EthicalAesthetic/kavacha/coremark/coremark_sim.png

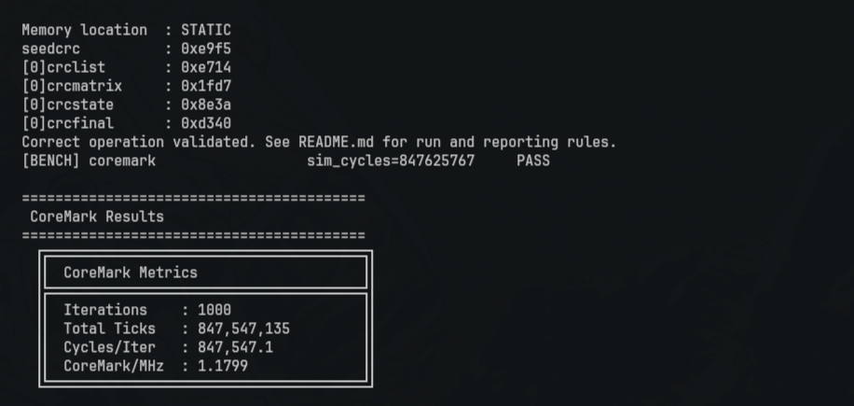
coremark/coremark_sim.png
