EthicalAesthetic/kavacha/dhrystone/dhry_sim.png

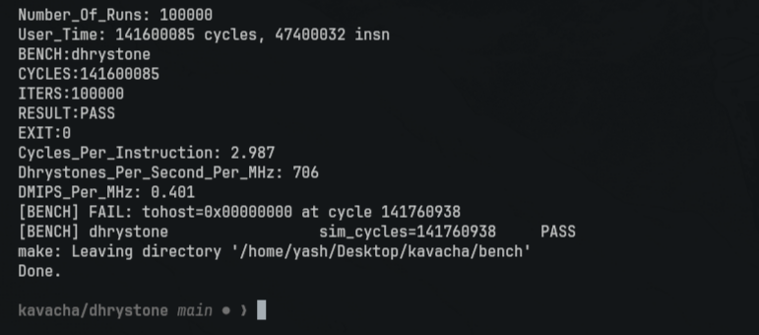
dhrystone/dhry_sim.png
