EthicalAesthetic/kavacha/tb/tb_kavacha.sv

// ============================================================================
// tb_kavacha.sv — Self-checking testbench for kavacha_soc.
//
//   vvp sim/tb_kavacha +IMEM=programs/build/smoke.hex
//   vvp sim/tb_kavacha +IMEM=... +TRACE=1   (emit retire trace for co-sim)
//   vvp sim/tb_kavacha +IMEM=... +DRAM=<hex>  (also preload DRAM @0x8000_0000)
//   vvp sim/tb_kavacha +IMEM=... +MAXCYC=<n>  (cycle limit, default 200000)
//   vvp sim/tb_kavacha +IMEM=... +IMEM_WRITABLE
//       testbench memory model only: data stores into the IMEM window also
//       update IMEM (the SoC's IMEM is fetch + read-only data). run_isa.sh uses
//       it because riscv-tests expect one read/write memory (rv32uc/rvc stores
//       into data placed in its own code section).
//
// Exit protocol: a store to tohost (0x2000_0000) ends the run.
//   tohost == 1  -> PASS
//   tohost != 1  -> FAIL
// ============================================================================
`timescale 1ns/1ps

module tb_kavacha;
  logic clk = 1'b0;
  always #5 clk = ~clk;

  logic rst;

  logic [31:0] tohost;
  logic        tohost_we;
  logic        retire_valid;
  logic [31:0] retire_pc, retire_instr, retire_rd_val;
  logic        retire_rd_we;
  logic [4:0]  retire_rd;

  kavacha_soc dut (
    .clk(clk), .rst(rst),
    .tck(1'b0), .tms(1'b0), .tdi(1'b0), .tdo(),
    .tohost(tohost), .tohost_we(tohost_we),
    .retire_valid(retire_valid), .retire_pc(retire_pc),
    .retire_instr(retire_instr), .retire_rd_we(retire_rd_we),
    .retire_rd(retire_rd), .retire_rd_val(retire_rd_val)
  );

  string imem_file, dram_file;
  integer trace_en;
  integer max_cyc = 200000;
  integer i;

  initial begin
    if (!$value$plusargs("IMEM=%s", imem_file)) begin
      $display("FATAL: no +IMEM=<file> given");
      $finish;
    end
    trace_en = 0;
    if ($value$plusargs("TRACE=%d", trace_en)) ;
    if ($value$plusargs("MAXCYC=%d", max_cyc)) ;

    // clear memories
    for (i = 0; i < 8192; i = i + 1) begin
      dut.imem[i] = 32'h0000_0013;   // NOP fill
      dut.dram[i] = 32'h0;
    end

    $display("[TB] Loading IMEM from: %s", imem_file);
    $readmemh(imem_file, dut.imem);
    if ($value$plusargs("DRAM=%s", dram_file)) begin
      $display("[TB] Loading DRAM from: %s", dram_file);
      $readmemh(dram_file, dut.dram);
    end

    if ($test$plusargs("VCD")) begin
      $dumpfile("tb_kavacha.vcd");
      $dumpvars(0, tb_kavacha);
    end

    rst = 1'b1;
    repeat (4) @(posedge clk);
    rst = 1'b0;
    $display("[TB] Reset released");
  end

  // retire trace for co-simulation
  always @(posedge clk) begin
    if (!rst && trace_en && retire_valid) begin
      $display("RETIRE pc=%08x instr=%08x rdwe=%0d rd=%0d rdval=%08x",
               retire_pc, retire_instr, retire_rd_we, retire_rd, retire_rd_val);
    end
  end

  // optional writable IMEM (see header)
  integer imem_wr = 0;
  integer b;
  initial if ($test$plusargs("IMEM_WRITABLE")) imem_wr = 1;
  always @(posedge clk) begin
    if (imem_wr != 0 && !rst && dut.dmem_we && dut.in_imem)
      for (b = 0; b < 4; b = b + 1)
        if (dut.dmem_be[b]) dut.imem[dut.imem_didx][b*8 +: 8] <= dut.dmem_wdata[b*8 +: 8];
  end

  // exit on tohost
  integer cycle = 0;
  always @(posedge clk) begin
    if (!rst) cycle <= cycle + 1;
    if (tohost_we) begin
      $display("[TB] tohost write: 0x%08x at cycle %0d", tohost, cycle);
      if (tohost == 32'd1) $display("[TB] PASS");
      else                 $display("[TB] FAIL (code %0d)", tohost);
      $finish;
    end
    if (cycle > max_cyc) begin
      $display("[TB] TIMEOUT — no tohost write");
      $finish;
    end
  end
endmodule
