EthicalAesthetic/kavacha/(commit log)

2026-09-04 fix: resolve RTL compile issues, restore test programs, and fix benchmark harnesses
    [bin2hex.py, kavacha_axil.sv, kavacha_core.sv, kavacha_fpga.sv, kavacha_immgen.sv, main.cpp]
2026-09-09 bench: Fix timeouts, EMBench scales, and improve CoreMark reporting
    [main.cpp]
2026-09-09 bench: fixed timeout for fpga of dhrystone and README improvement
    [run_hil_bench.py]
2026-09-17 Fix: remove fallback toolchain paths
    [run_hil_bench.py]
2026-09-19 Correct README claims and add CI
    README (P0 accuracy fixes):
    - Debug: DM/DTM report debug spec 0.13 (dmstatus.version = 2)
    - ePMP -> Smepmp (ratified name); build target names unchanged
    - Verification section: describe what is run (smoke-program co-simulation
    against the RV32IM model, RVFI trace self-check); riscv-formal not yet run
    - Benchmarks: tables came from cycle-accurate simulation, not the Arty A7;
    column headers now say so
    CI (new): smoke, cosim, rvfi, debug, pmp, epmp and ecc on Icarus Verilog,
    with Ubuntu's RISC-V GCC for the PMP test programs. All steps pass in an
    Ubuntu 24.04 container.
2026-09-19 SECURE: enforce Smepmp MML, trap U-mode CSR/MRET, fix load-fault traps
    Security fixes for the SECURE build:
    - kavacha_pmp: implement the Smepmp 1.0 MML truth table (L=1 rules are
    M-only, L=0 rules are U-only, shared-region encodings) and deny M-mode
    execution from memory that matches no rule when MML is set
    - kavacha_csr: with MML=1 and RLB=0, ignore pmpcfg writes that would add an
    executable M-only or locked shared-code rule; RLB can no longer be set
    while any rule is locked
    - kavacha_core: in U-mode, CSR access with addr[9:8] != 00 and MRET raise
    illegal-instruction traps (mtval = instruction)
    Bug fix found by the new MML test:
    - a load that raised a synchronous trap in EXEC was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
    [kavacha_core.sv, kavacha_csr.sv, kavacha_pmp.sv]
2026-09-19 Official riscv-tests, fail-closed test scripts, three CSR fixes
    Test scripts now fail on failure:
    - build.sh: every target (sim, cosim, rvfi, debug, pmp, epmp, upriv, mml,
    ecc, axil, fpga) exits non-zero unless its testbench prints its PASS
    verdict and no FAIL/TIMEOUT/MISMATCH/FATAL/ERROR line (check_verdict).
    Proven by breaking each check in a throwaway copy (expected tohost value,
    cycle limit, idcode, ECC flag, UART byte count, golden model): each target
    fails, and passes again unmodified.
    - tools/cosim.py: an empty retire trace was reported as MATCH (exit 0);
    it is now a MISMATCH (exit 3).
    - CoreMark/Dhrystone: bench/Makefile pipes through tee with pipefail;
    run_dhrystone.sh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
    [kavacha_core.sv, kavacha_csr.sv, kavacha_pkg.sv, tb_kavacha.sv]
